curtisgalloway/rear-projection-display/LED-board-outline-mm.dxf

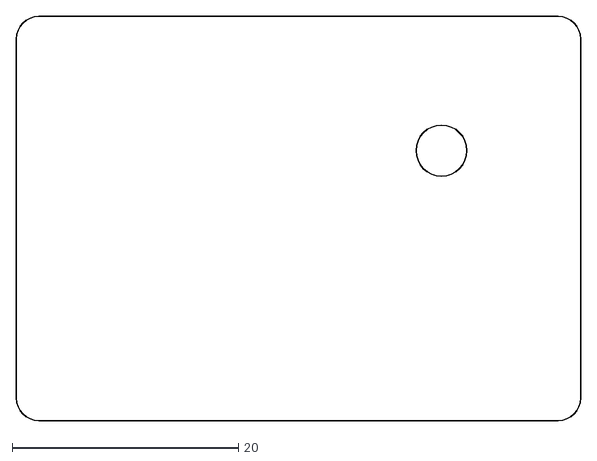
[picture p1: CAD file, 2026-05-15]
LED-board-outline-mm.dxf
49.9 x 35.7
