curtisgalloway/rear-projection-display/led-indicator/led-indicator/SN74AHCT125DR/SN74AHCT125DR.step

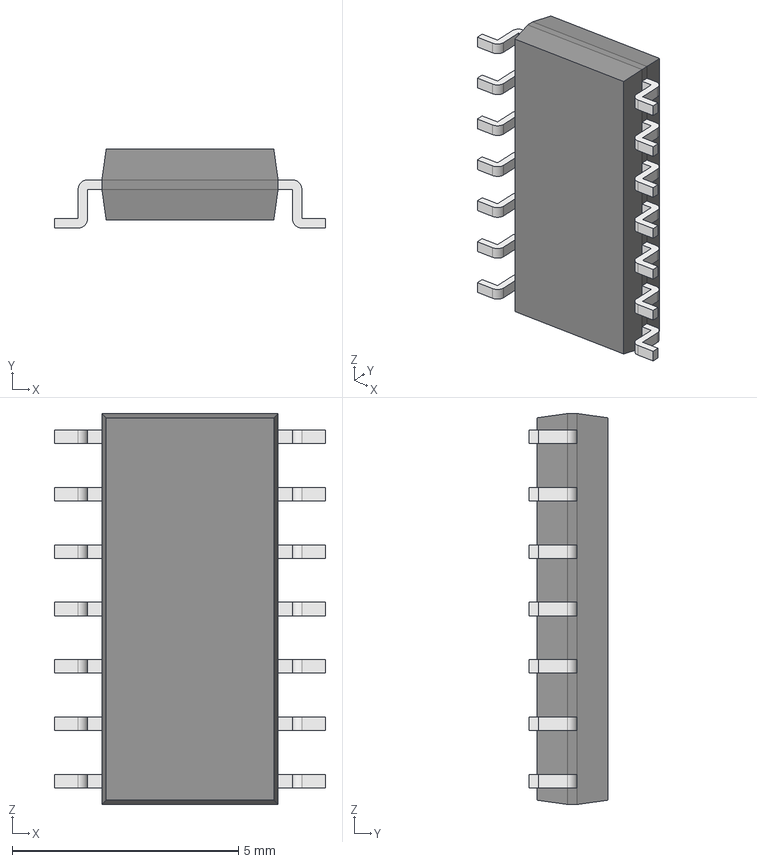
[picture p2: CAD file, 2026-05-15]
led-indicator/led-indicator/SN74AHCT125DR/SN74AHCT125DR.step
6.00 x 1.75 x 8.65 mm
Body001 (Mirror #1) x 7
XY-plane x 12
X-axis x 12
