curtisgalloway/rear-projection-display/led-indicator/led-indicator/led-indicator.kicad_pcb

## KiCad design led-indicator/led-indicator/led-indicator.kicad_pcb (2026-05-16)

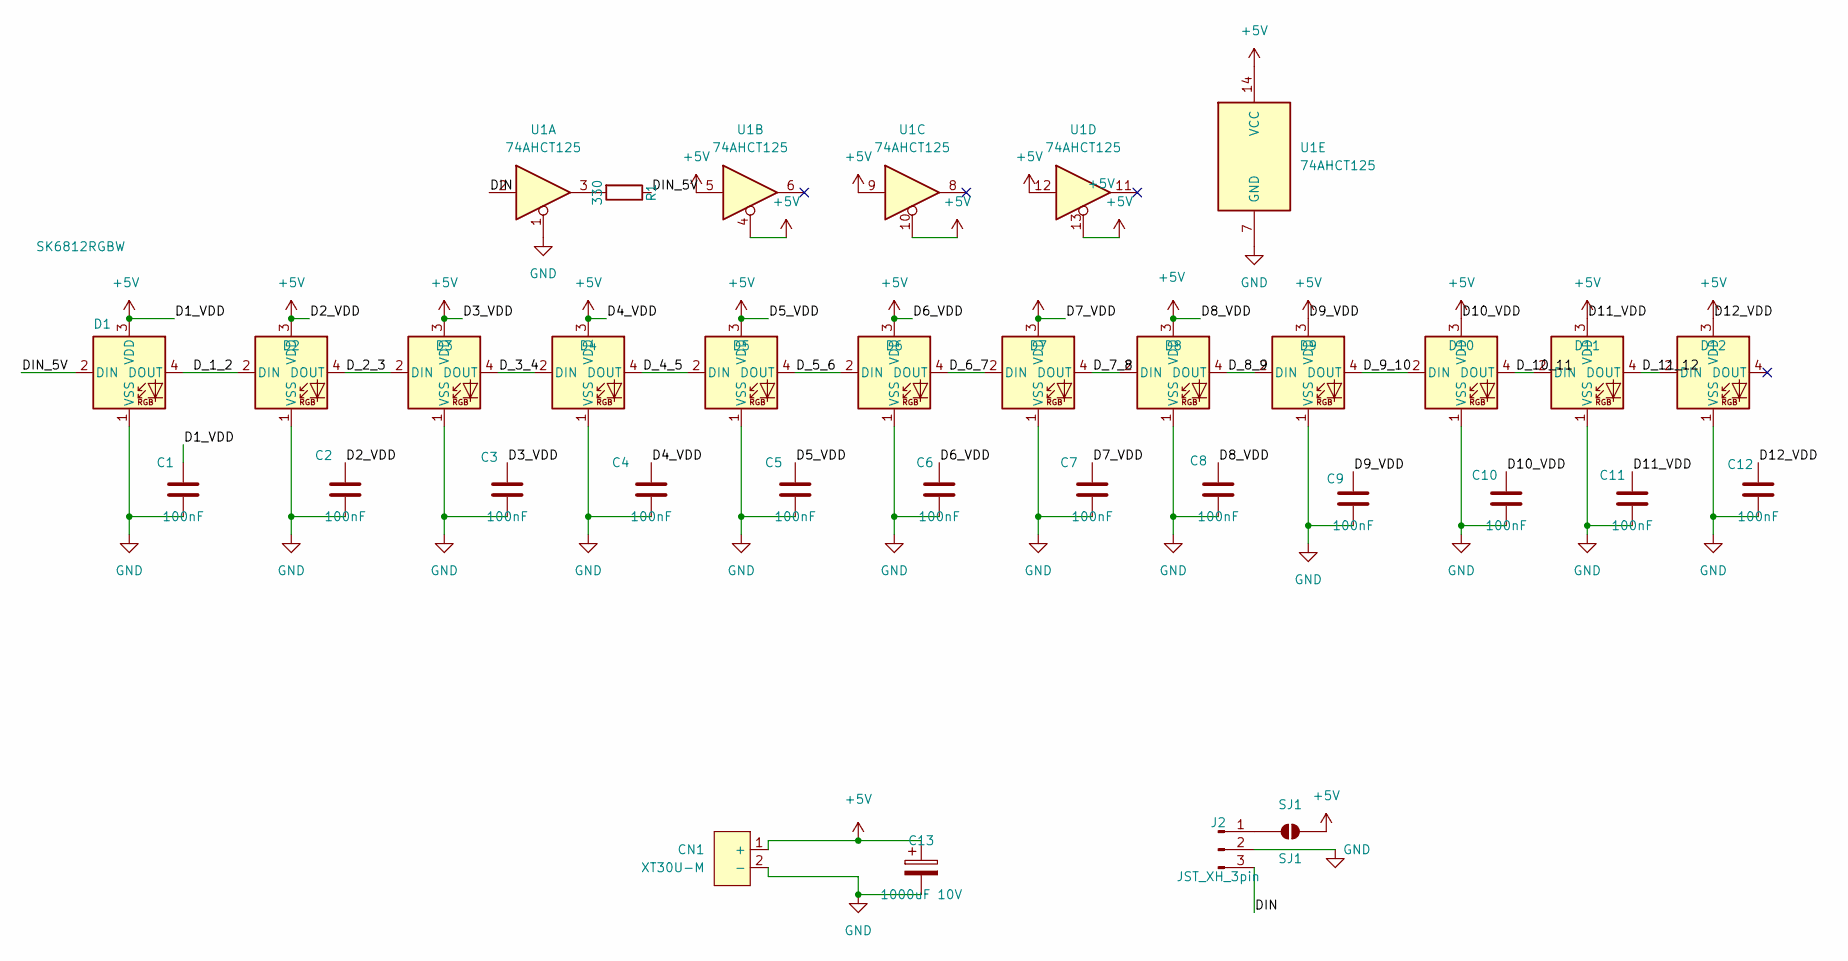
[picture p3: schematic led-indicator.kicad_sch]

Parts:
C1, C2, C3, C4, C5, C6, C7, C8, C9, C10, C11, C12: 100nF; C_0603_1608Metric; MPN CC0603KRX7R9BB104; LCSC C14663
C13: 1000uF 10V; CP_Radial_D8.0mm_P3.50mm; MPN GR108M010F12RR0VL4FP0; LCSC C3299
CN1: XT30U-M; AMASS_XT30U-M_1x02_P5.0mm_Vertical; MPN XT30U-M; LCSC Part C99101
D1, D2, D3, D4, D5, D6, D7, D8, D9, D10, D11, D12: SK6812RGBW; LED_SK6812_PLCC4_5.0x5.0mm_P3.2mm; MPN XL-5050RGBWC-WS2812B; LCSC C22464516
J2: JST_XH_3pin; JST_XH_B3B-XH-A_1x03_P2.50mm_Vertical; MPN B3B-XH-A(LF)(SN); LCSC C144394
R1: 330; R_0603_1608Metric; MPN 0603WAF3300T5E; LCSC C23138
SJ1: SJ1; SolderJumper-2_P1.3mm_Open_RoundedPad1.0x1.5mm
U1: 74AHCT125; SOIC-14_3.9x8.7mm_P1.27mm; MPN 74AHCT125S14-13; LCSC C842299

Connections:
+5V: C1.1, C2.1, C3.1, C4.1, C5.1, C6.1, C7.1, C8.1, C9.1, C10.1, C11.1, C12.1, C13.1, CN1.1 (+), D1.3 (VDD), D2.3 (VDD), D3.3 (VDD), D4.3 (VDD), D5.3 (VDD), D6.3 (VDD), D7.3 (VDD), D8.3 (VDD), D9.3 (VDD), D10.3 (VDD), D11.3 (VDD), D12.3 (VDD), SJ1.2 (B), U1.4, U1.5, U1.9, U1.10, U1.12, U1.13, U1.14 (VCC)
/DIN: J2.3, U1.2
/DIN_5V: D1.2 (DIN), R1.1
/D_1_2: D1.4 (DOUT), D2.2 (DIN)
/D_2_3: D2.4 (DOUT), D3.2 (DIN)
/D_3_4: D3.4 (DOUT), D4.2 (DIN)
/D_4_5: D4.4 (DOUT), D5.2 (DIN)
/D_5_6: D5.4 (DOUT), D6.2 (DIN)
/D_6_7: D6.4 (DOUT), D7.2 (DIN)
/D_7_8: D7.4 (DOUT), D8.2 (DIN)
/D_8_9: D8.4 (DOUT), D9.2 (DIN)
/D_9_10: D9.4 (DOUT), D10.2 (DIN)
/D_10_11: D10.4 (DOUT), D11.2 (DIN)
/D_11_12: D11.4 (DOUT), D12.2 (DIN)
GND: C1.2, C2.2, C3.2, C4.2, C5.2, C6.2, C7.2, C8.2, C9.2, C10.2, C11.2, C12.2, C13.2, CN1.2 (-), D1.1 (VSS), D2.1 (VSS), D3.1 (VSS), D4.1 (VSS), D5.1 (VSS), D6.1 (VSS), D7.1 (VSS), D8.1 (VSS), D9.1 (VSS), D10.1 (VSS), D11.1 (VSS), D12.1 (VSS), J2.2, U1.1, U1.7 (GND)
unnamed: J2.1, SJ1.1 (A)
unnamed: R1.2, U1.3

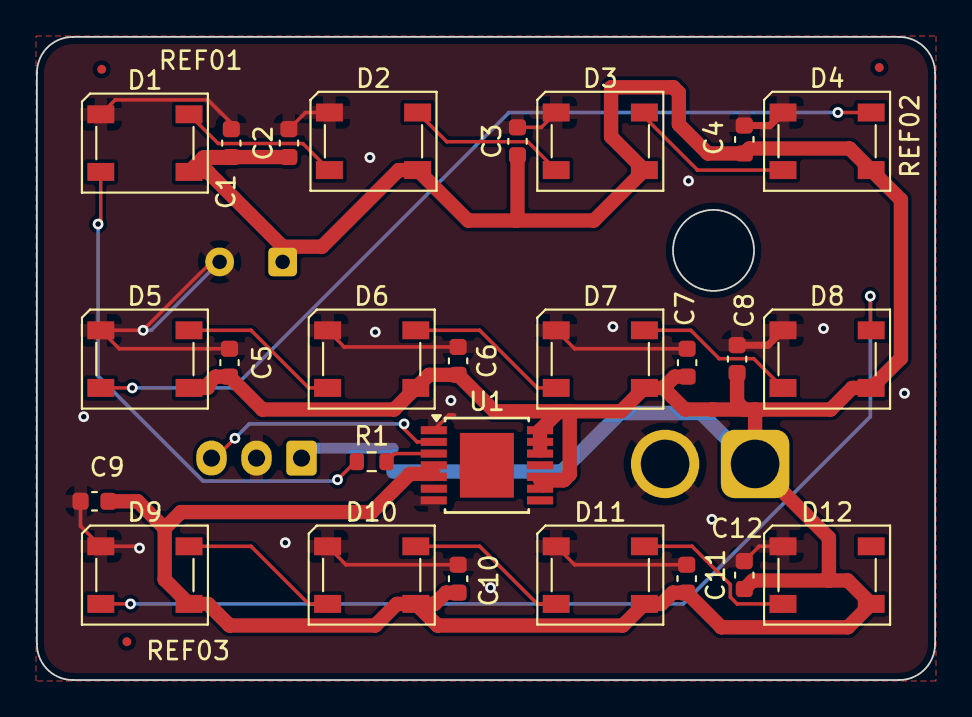
[picture p4: board led-indicator.kicad_pcb from above]

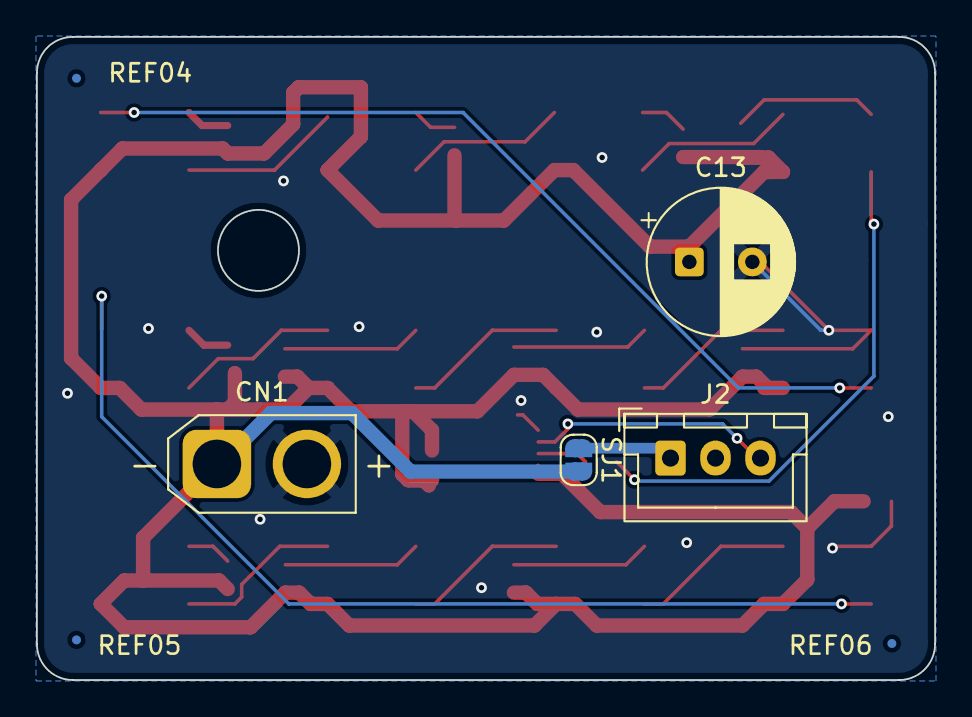
[picture p5: board led-indicator.kicad_pcb from below]

Board: 2 copper layers, 49.9 x 35.7 mm, 36 parts (7 on the bottom side), 17 nets.

Other parts of the board:
REF01, REF02, REF03, REF04, REF05, REF06: Fiducial_0.5mm_Mask1mm
