curtisgalloway/rear-projection-display/(commit log)

2026-05-11 Initial commit: IS31FL3236A LED driver board schematic and PCB
    12-LED RGB rear-projection display board driven by an IS31FL3236A
    36-channel LED driver over I2C (QWIIC connector). Features:
    - gen_schematic.py: Python script that generates the KiCad schematic
    - Custom LED_RGB_10mm 4-pin through-hole footprint (1.27mm pitch)
    - Custom IS31FL3236A-QFLS2-TR QFN-44 symbol and footprint from SnapMagic
    - 4x3 LED grid wired to IS31FL3236A channels 1-36 (R/G/B per LED)
    - I2C pull-up resistors, decoupling caps, QWIIC vertical connector
    - Board outline: 49.9mm x 35.73mm
    [IS31FL3236A-QFLS2-TR.step, LED board layout.dxf, LED-board-outline-mm.dxf, board.step, board.stl, rear-projection-display.kicad_pcb, rear-projection-display.kicad_sch]
2026-05-11 Add interior housing hole cutout to board outline
    Adds a 2.25mm-radius circular cutout on Edge.Cuts at (166.09, 95.36)
    per the updated board outline DXF. Corresponds to DXF position
    (12.64, 6.005) relative to board center.
    [rear-projection-display.kicad_pcb]
2026-05-11 Remove first try at making a board with through-hole LEDs.
    [IS31FL3236A-QFLS2-TR.step, board.step, board.stl, rear-projection-display.kicad_pcb, rear-projection-display.kicad_sch]
2026-05-15 Add led-indicator KiCad project with design review fixes applied
    New sub-project: a 12-LED SK6812 RGBW addressable indicator panel to
    replace incandescent bulbs in the rear-projection display. Includes
    schematic, PCB layout, and kicad-happy analysis outputs.
    Design review fixes applied:
    - Fix #2 (R1 placement): Moved R1 to the correct side of the level
    shifter (U1A output, pin Y1) rather than in front of the input.
    DIN net label now connects J2 DATA to U1A.A1; DIN_5V connects U1A.Y1
    through R1 to D1.DIN per the intended schematic.
    - Fix #4 (D1 value): Corrected D1 value from "12x SK6812RGBW" to
    "SK6812RGBW" to match standard BOM format.
    - Fix #5 (copper pours): Added GND copper pour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
    [LED-board-outline-mm.dxf, SN74AHCT125DR.step, led-indicator.kicad_pcb, led-indicator.kicad_sch]
2026-05-15 led-indicator: PCB fixes, +5V trace widening, datasheet and CN1 reconciliation
    PCB fixes:
    - PM-001: Move C8 to (161.7, 102.8) and C12 to (161.7, 114.8) — aligned
    with C4 pattern, to the left of D8/D12 instead of to the right where the
    LED courtyard and board edge left no valid placement zone
    - PM-002: Move FID2 to (169.35, 87.85) — 3mm inset from corner clears the
    Fiducial_1mm_Mask2mm courtyard from the board edge
    - FD-001: Add FID4/FID5/FID6 on B.Cu at 3mm inset from corners to support
    back-side SMD assembly pass (U1 SOIC-14, R1 0603, SJ1 solder jumper)
    - XV-002: Update PCB D1 value to "SK6812RGBW" to match schematic
    +5V trace widening:
    - All 96 +5V segments (F.Cu and B.Cu) wid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
    [led-indicator.kicad_pcb, led-indicator.kicad_sch]
2026-05-15 led-indicator: manual rerouting and schematic edits
    Manual PCB re-routing after previous trace-width widening caused
    clearance violations. Includes schematic updates made during the same
    editing session. Also removes stale LED board layout DXF and updates
    the board outline DXF.
    [LED board layout.dxf, LED-board-outline-mm.dxf, led-indicator.kicad_pcb, led-indicator.kicad_sch]
2026-05-15 led-indicator: add fiducials for double-sided SMD assembly
    Place 6 Fiducial_0.5mm_Mask1mm footprints for JLCPCB pick-and-place
    alignment — 3 on F.Cu (REF01/02/03) and 3 on B.Cu (REF04/05/06) near
    board corners. DRC clean: 0 violations, 0 unconnected.
    [led-indicator.kicad_pcb]
2026-05-16 led-indicator: add LCSC/MPN part numbers to all BOM components
    Sets LCSC and MPN hidden properties on all 29 purchasable components
    for JLCPCB assembly ordering:
    C1-C12 C14663 CC0603KRX7R9BB104 100nF 0603 (Basic)
    C13 C3299 GR108M010F12RR0VL4FP0 1000uF 10V radial THT
    D1-D12 C22464516 XL-5050RGBWC-WS2812B SK6812-compat 5050 RGBW
    J2 C144394 B3B-XH-A(LF)(SN) JST XH 3-pin
    R1 C23138 0603WAF3300T5E 330R 0603 (Basic)
    U1 C842299 74AHCT125S14-13 Diodes Inc SO-14
    CN1 C108769 XT30UPB-F30.G.Y XT30 power connector (hand-solder)
    Note: replaced original LED part C2890364 (3528 package) with C22464516
    (conf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
    [led-indicator.kicad_sch]
2026-05-16 led-indicator: replace CN1 with XT30U-M (male) connector
    Switch CN1 from XT30UPB-F (female, C108769) to XT30U-M (male, C99101).
    The male connector mates with the battery's female harness plug.
    Updated both schematic and PCB:
    - Footprint: AMASS_XT30UPB-F → AMASS_XT30U-M (drill 1.8mm → 2.7mm,
    pad size 3×3mm → 3.8×3.8mm, roundrect ratio 0.25 → 0.2)
    - LCSC Part: C108769 → C99101
    - MPN: XT30UPB-F30.G.Y → XT30U-M
    - Refilled copper zones after pad size change; DRC clean (0 errors,
    0 unconnected — only pre-existing C7 library mismatch warning remains)
    [led-indicator.kicad_pcb, led-indicator.kicad_sch]
2026-05-16 led-indicator: fix schematic corruption and add fabrication outputs
    Schematic had two systemic corruption issues introduced by the earlier
    MPN/LCSC property-setting script:
    1. Properties inside symbol blocks had an invalid (uuid ...) child element
    that kicad-cli's parser rejects; removed 95 such lines.
    2. Duplicate property blocks were placed at the kicad_sch root level
    (outside any symbol block) after each symbol's closing paren; removed
    31 orphaned blocks (31 property pairs).
    After repair, kicad-cli loads the schematic cleanly.
    Added fab/ outputs for JLCPCB ordering:
    - fab/gerbers/ F.Cu, B.Cu, F/B.Mask, F/B.Silk, F/B.Paste, Edge.Cuts,
    F/B.Courtyard, PTH.drl, NPT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
    [led-indicator-B_Courtyard.gbr, led-indicator-B_Cu.gbl, led-indicator-B_Mask.gbs, led-indicator-B_Paste.gbp, led-indicator-B_Silkscreen.gbo, led-indicator-Edge_Cuts.gm1, led-indicator-F_Courtyard.gbr, led-indicator-F_Cu.gtl]
2026-05-16 led-indicator: add .gitignore and commit project settings
    Ignore loose *.gbr / gerber/ exports in the project root (superseded by
    fab/gerbers/). Commit updated .kicad_prl and .kicad_pro reflecting
    current board state.
2026-05-16 led-indicator: fix BOM/CPL for JLCPCB upload
    BOM: use comma-separated individual designators instead of dash-ranges
    (C1-C12 → C1,C2,...,C12) so JLCPCB can match against CPL entries.
    CPL: exclude fiducials (REF01-REF06) and SJ1 (no LCSC part) — JLCPCB
    was rejecting the upload because these appeared in the CPL but not the BOM.
    [led-indicator-bom-jlcpcb.csv, led-indicator-bom-raw.csv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]
2026-05-16 led-indicator: exclude through-hole parts from PCBA BOM and CPL
    Remove C13 (1000uF radial, C3299) and CN1 (XT30U-M, C99101) from both
    the JLCPCB BOM and CPL. Both are through-hole and will be hand-soldered
    after the SMT run.
    [led-indicator-bom-jlcpcb.csv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]
2026-05-16 led-indicator: add through-hole parts back to BOM for JLCPCB sourcing
    C13 and CN1 are back in the BOM so JLCPCB will source and include them,
    but they remain absent from the CPL so they won't be placed.
    [led-indicator-bom-jlcpcb.csv]
2026-05-16 Updated to be single-sided board.
    [led-indicator.kicad_pcb]
